ferdamarc/Projeto-ComunicacaoDigital/report/imgs/buzzer_flowchart.png

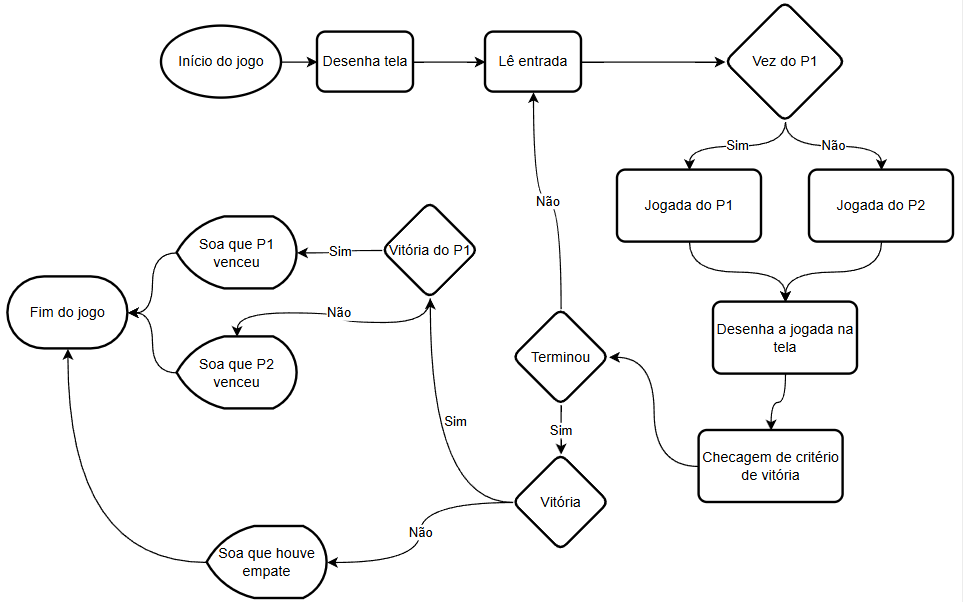
report/imgs/buzzer_flowchart.png
