ferdamarc/Projeto-ComunicacaoDigital/report/imgs/connection_diagram.png

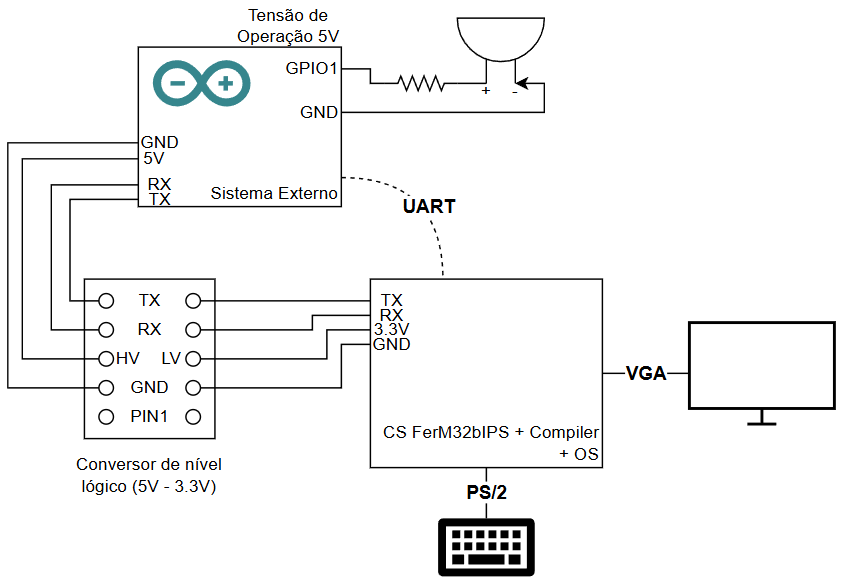
report/imgs/connection_diagram.png
