ferdamarc/Projeto-ComunicacaoDigital/schematics/instrucoes-novas.ods

Instruções | Opcode | Periférico | Efeito
draw_pixel | 0b001111 | VGA (Monitor) | Escreve a cor de um pixel no framebuffer
keyboard_input | 0b010111 | PS/2 (Teclado) | Lê o código ASCII da última tecla pressionada
uart_send | 0b011000 | UART | Transmite 8 bits pela linha serial
uart_receive | 0b011001 | UART | Lê o conjunto de 8 bits recebido e o consome
uart_rx_available | 0b011010 | UART | Indica se tem mensagem recebida pendente
uart_tx_ready | 0b011011 | UART | Indica se o transmissor está livre
