ferdamarc/Projeto-ComunicacaoDigital/(commit log)

2026-06-30 docs(schematic): add the project datapath schematic
2026-06-30 refactor(buzzer): remove unused globals and pitch definitions
2026-06-30 feat(buzzer): enhance buzzer functionality with UART communication and melody playback
    [buzzer.ino]
2026-06-30 refactor(buzzer): remove commented-out documentation and clean up code
    [buzzer.ino]
2026-07-06 feat(report): add detailed explanation of UART handshake and Arduino sketch integration
2026-07-06 feat(report): add detailed explanation of compiler modifications for C- functions and UART handshake
2026-07-16 feat(instructions): add new instructions spreadsheet for opcode
    [instrucoes-novas.ods]
2026-07-16 refac(diagrams): updates connection wiring for the new GVA, PS/2, and UART modules
